je1rav/Mini_Solar_FM_Radio/images/FM-Radio_curcuit.pdf

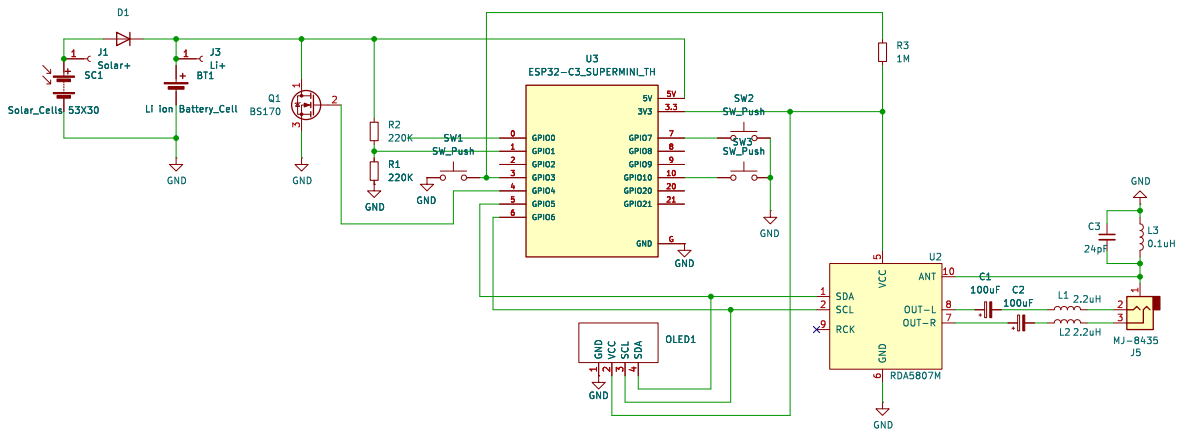
[picture p10: page 1]
